DKxai/Upper-Limb-Tracking/Calib/accel_calib2_report.xlsx

Sheet: TongHop
KẾT QUẢ HIỆU CHUẨN ACCEL (mô hình a = S (ã − B))
S (ma trận đối xứng) | col X | col Y | col Z
row X | 1.004494 | 4.3e-05 | 0.003032
row Y | 4.3e-05 | 1.000284 | -0.000519
row Z | 0.003032 | -0.000519 | 0.981801
Bias B | X | Y | Z
g | 0.033737 | -0.008428 | -0.000734
m/s² | 0.330852 | -0.08265 | -0.007194
Chỉ tiêu (||a|| so với g) | TRƯỚC | SAU
RMS sai số (g) | 0.02137 | 0.00018
Max |sai số| (g) | 0.03812 | 0.00045
Std ||a|| (g) | 0.02076 | 0.00018

Sheet: DoiChieu
position | norm_THO_g | norm_HIEUCHUAN_g | chuan_g
1 | 1.01688 | 1.00038 | 1
2 | 1.00165 | 0.99955 | 1
3 | 1.01344 | 0.99985 | 1
4 | 1.02715 | 1.00011 | 1
5 | 0.9845 | 0.9998 | 1
6 | 1.02191 | 1.00014 | 1
7 | 1.01755 | 1.00029 | 1
8 | 1.00792 | 0.99975 | 1
9 | 1.03486 | 1.00007 | 1
10 | 0.98628 | 0.99967 | 1
11 | 0.96188 | 1.00014 | 1
12 | 0.98137 | 0.99999 | 1
13 | 0.96864 | 1.0002 | 1
14 | 0.98628 | 1.00008 | 1
15 | 0.98124 | 1.00004 | 1
16 | 1.0289 | 0.99991 | 1
17 | 1.0271 | 0.9998 | 1
18 | 1.03441 | 0.99981 | 1
19 | 1.01439 | 1.00005 | 1
20 | 1.02616 | 1.00004 | 1
21 | 1.00829 | 0.99984 | 1
22 | 1.01433 | 1.0001 | 1
23 | 1.01633 | 0.99991 | 1
24 | 1.02645 | 1.00005 | 1
25 | 0.98158 | 1.00001 | 1
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
