DKxai/Upper-Limb-Tracking/Calib/accel_calib3_report.xlsx

Sheet: TongHop
KẾT QUẢ HIỆU CHUẨN ACCEL (mô hình a = S (ã − B))
S (ma trận đối xứng) | col X | col Y | col Z
row X | 1.000799 | -0.00019 | -0.000277
row Y | -0.00019 | 0.999013 | -0.002093
row Z | -0.000277 | -0.002093 | 0.980925
Bias B | X | Y | Z
g | 0.021174 | -0.001438 | 0.259063
m/s² | 0.207642 | -0.014107 | 2.540536
Chỉ tiêu (||a|| so với g) | TRƯỚC | SAU
RMS sai số (g) | 0.15611 | 0.00025
Max |sai số| (g) | 0.27923 | 0.0007
Std ||a|| (g) | 0.15222 | 0.00025

Sheet: DoiChieu
position | norm_THO_g | norm_HIEUCHUAN_g | chuan_g
1 | 1.27923 | 1.0007 | 1
2 | 1.21735 | 1.00065 | 1
3 | 1.2212 | 1.00001 | 1
4 | 1.22541 | 0.99964 | 1
5 | 1.24324 | 0.99988 | 1
6 | 0.76073 | 0.99983 | 1
7 | 0.86547 | 1.00002 | 1
8 | 0.83999 | 0.99997 | 1
9 | 0.82242 | 0.99986 | 1
10 | 0.86183 | 1.00012 | 1
11 | 1.00682 | 1.00014 | 1
12 | 1.01954 | 1.00004 | 1
13 | 1.01612 | 1 | 1
14 | 1.18371 | 0.99999 | 1
15 | 0.82091 | 1.00031 | 1
16 | 1.04655 | 1.00003 | 1
17 | 0.847 | 0.99993 | 1
18 | 1.23595 | 0.99964 | 1
19 | 1.04306 | 1.00025 | 1
20 | 1.04699 | 0.99992 | 1
21 | 1.03933 | 1.00002 | 1
22 | 1.21676 | 0.99938 | 1
23 | 0.86581 | 1.00004 | 1
24 | 1.01822 | 0.99978 | 1
25 | 1.05558 | 1.00012 | 1
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
