DKxai/Upper-Limb-Tracking/Calib/accel_calib4_report.xlsx

Sheet: TongHop
KẾT QUẢ HIỆU CHUẨN ACCEL (mô hình a = S (ã − B))
S (ma trận đối xứng) | col X | col Y | col Z
row X | 0.997803 | -7.7e-05 | 0.001582
row Y | -7.7e-05 | 0.994631 | -0.002504
row Z | 0.001582 | -0.002504 | 0.979767
Bias B | X | Y | Z
g | 0.03441 | -0.013384 | -0.06569
m/s² | 0.337451 | -0.131252 | -0.644201
Chỉ tiêu (||a|| so với g) | TRƯỚC | SAU
RMS sai số (g) | 0.04457 | 0.00023
Max |sai số| (g) | 0.09023 | 0.0006
Std ||a|| (g) | 0.04361 | 0.00023

Sheet: DoiChieu
position | norm_THO_g | norm_HIEUCHUAN_g | chuan_g
1 | 0.95234 | 0.99977 | 1
2 | 0.9568 | 0.99954 | 1
3 | 0.97329 | 0.99978 | 1
4 | 0.94228 | 0.99967 | 1
5 | 0.97773 | 0.99994 | 1
6 | 1.09023 | 1.00033 | 1
7 | 1.03603 | 1.0001 | 1
8 | 1.07758 | 1.00011 | 1
9 | 1.05559 | 1.00001 | 1
10 | 1.07964 | 0.99988 | 1
11 | 0.97824 | 1.00006 | 1
12 | 0.97837 | 1.00019 | 1
13 | 0.99422 | 1.00014 | 1
14 | 0.94339 | 1.00033 | 1
15 | 1.04457 | 0.99992 | 1
16 | 1.02931 | 0.99993 | 1
17 | 0.9816 | 0.99994 | 1
18 | 1.07524 | 0.99997 | 1
19 | 1.01787 | 1.00001 | 1
20 | 1.03313 | 1.00005 | 1
21 | 1.02142 | 0.99997 | 1
22 | 0.97375 | 1.00047 | 1
23 | 1.07574 | 0.99975 | 1
24 | 1.03387 | 1.00007 | 1
25 | 0.99757 | 0.99977 | 1
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
