DKxai/Upper-Limb-Tracking/Calib/accel_calib5_report.xlsx

Sheet: TongHop
KẾT QUẢ HIỆU CHUẨN ACCEL (mô hình a = S (ã − B))
S (ma trận đối xứng) | col X | col Y | col Z
row X | 0.99854 | -1.4e-05 | 2.4e-05
row Y | -1.4e-05 | 0.998468 | -0.000963
row Z | 2.4e-05 | -0.000963 | 0.990635
Bias B | X | Y | Z
g | 0.034745 | -0.01351 | -0.006169
m/s² | 0.340734 | -0.13249 | -0.060494
Chỉ tiêu (||a|| so với g) | TRƯỚC | SAU
RMS sai số (g) | 0.02171 | 0.0002
Max |sai số| (g) | 0.03648 | 0.00039
Std ||a|| (g) | 0.02116 | 0.0002

Sheet: DoiChieu
position | norm_THO_g | norm_HIEUCHUAN_g | chuan_g
1 | 1.00782 | 1.00004 | 1
2 | 0.99509 | 1.00013 | 1
3 | 1.01394 | 1.00009 | 1
4 | 0.98549 | 0.99979 | 1
5 | 1.02572 | 1.00031 | 1
6 | 1.01238 | 0.99986 | 1
7 | 0.98501 | 1.00024 | 1
8 | 1.02741 | 1.00032 | 1
9 | 0.99463 | 0.99988 | 1
10 | 1.0187 | 0.99967 | 1
11 | 0.96614 | 0.99971 | 1
12 | 0.98433 | 0.99972 | 1
13 | 0.981 | 1.00018 | 1
14 | 0.9681 | 1.00007 | 1
15 | 0.98943 | 1.00009 | 1
16 | 1.03589 | 0.99978 | 1
17 | 1.01627 | 1.00014 | 1
18 | 1.03531 | 0.99994 | 1
19 | 1.02756 | 0.99999 | 1
20 | 1.03316 | 0.99998 | 1
21 | 1.01727 | 1 | 1
22 | 1.01954 | 1.00032 | 1
23 | 1.0138 | 0.9998 | 1
24 | 0.99 | 1.00017 | 1
25 | 1.03648 | 0.99999 | 1
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
