DKxai/Upper-Limb-Tracking/Calib/accel_calib6_report.xlsx

Sheet: TongHop
KẾT QUẢ HIỆU CHUẨN ACCEL (mô hình a = S (ã − B))
S (ma trận đối xứng) | col X | col Y | col Z
row X | 1.006291 | -7.9e-05 | -0.001651
row Y | -7.9e-05 | 1.003179 | -2.4e-05
row Z | -0.001651 | -2.4e-05 | 0.994116
Bias B | X | Y | Z
g | 0.019748 | -0.010122 | -0.023445
m/s² | 0.193657 | -0.099262 | -0.229912
Chỉ tiêu (||a|| so với g) | TRƯỚC | SAU
RMS sai số (g) | 0.01891 | 0.00033
Max |sai số| (g) | 0.03241 | 0.00093
Std ||a|| (g) | 0.01889 | 0.00033

Sheet: DoiChieu
position | norm_THO_g | norm_HIEUCHUAN_g | chuan_g
1 | 0.98348 | 0.99988 | 1
2 | 0.97737 | 0.99971 | 1
3 | 0.99336 | 0.99959 | 1
4 | 0.96759 | 0.99955 | 1
5 | 0.99791 | 0.99941 | 1
6 | 1.02858 | 1.00093 | 1
7 | 1.0084 | 0.99988 | 1
8 | 1.02781 | 0.99982 | 1
9 | 1.00754 | 1.00001 | 1
10 | 1.02846 | 1.00008 | 1
11 | 0.97473 | 1 | 1
12 | 0.97363 | 1.00009 | 1
13 | 0.98809 | 1.00004 | 1
14 | 1.00536 | 0.99961 | 1
15 | 0.96797 | 1.00025 | 1
16 | 1.01317 | 1.00005 | 1
17 | 0.99932 | 1.00054 | 1
18 | 1.0276 | 0.99982 | 1
19 | 1 | 1 | 1
20 | 1.01828 | 1.00022 | 1
21 | 1.00901 | 1.00019 | 1
22 | 0.98986 | 1.00022 | 1
23 | 1.01595 | 0.99983 | 1
24 | 0.99374 | 1.00043 | 1
25 | 1.02684 | 0.99958 | 1
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
