DKxai/Upper-Limb-Tracking/Calib/accel_calib_report1.xlsx

Sheet: TongHop
KẾT QUẢ HIỆU CHUẨN ACCEL (mô hình a = S (ã − B))
S (ma trận đối xứng) | col X | col Y | col Z
row X | 0.992636 | -0.000123 | 0.001343
row Y | -0.000123 | 0.994363 | -0.00107
row Z | 0.001343 | -0.00107 | 0.989107
Bias B | X | Y | Z
g | 0.044053 | -0.004345 | -0.111994
m/s² | 0.432008 | -0.042612 | -1.098284
Chỉ tiêu (||a|| so với g) | TRƯỚC | SAU
RMS sai số (g) | 0.07178 | 0.00019
Max |sai số| (g) | 0.12463 | 0.00038
Std ||a|| (g) | 0.07041 | 0.00019

Sheet: DoiChieu
position | norm_THO_g | norm_HIEUCHUAN_g | chuan_g
1 | 0.89918 | 0.99966 | 1
2 | 0.95685 | 1.00011 | 1
3 | 0.90087 | 1.00038 | 1
4 | 1.12463 | 0.99996 | 1
5 | 1.12351 | 1.00038 | 1
6 | 1.06949 | 1.00005 | 1
7 | 0.93147 | 0.99997 | 1
8 | 0.93099 | 1.00012 | 1
9 | 1.09451 | 0.99989 | 1
10 | 1.09325 | 0.99988 | 1
11 | 1.00504 | 1.00013 | 1
12 | 1.04196 | 0.99986 | 1
13 | 0.99284 | 0.99996 | 1
14 | 0.92839 | 1.00001 | 1
15 | 1.08845 | 0.99966 | 1
16 | 1.02071 | 1.00006 | 1
17 | 1.04728 | 1.00002 | 1
18 | 0.98945 | 0.99994 | 1
19 | 1.09792 | 0.99993 | 1
20 | 0.93772 | 1.00017 | 1
21 | 1.05681 | 0.99967 | 1
22 | 1.04572 | 0.99985 | 1
23 | 1.04243 | 1.00022 | 1
24 | 0.96418 | 1.00011 | 1
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
