DKxai/Upper-Limb-Tracking/Calib/accel_report.xlsx

Sheet: TongHop
KẾT QUẢ HIỆU CHUẨN ACCEL (mô hình a = S (ã − B))
S (ma trận đối xứng) | col X | col Y | col Z
row X | 1.01028 | -0.072398 | -0.009664
row Y | -0.072398 | 0.987549 | 0.005158
row Z | -0.009664 | 0.005158 | 1.004095
Bias B | X | Y | Z
g | 0.018231 | -0.030919 | 0.015079
m/s² | 0.17878 | -0.303211 | 0.147877
Chỉ tiêu (||a|| so với g) | TRƯỚC | SAU
RMS sai số (g) | 0.02485 | 0.0028
Max |sai số| (g) | 0.04319 | 0.00592
Std ||a|| (g) | 0.02471 | 0.0028

Sheet: DoiChieu
position | norm_THO_g | norm_HIEUCHUAN_g | chuan_g
1 | 1.01065 | 1.00497 | 1
2 | 0.98291 | 1.00585 | 1
3 | 1.01247 | 1.0005 | 1
4 | 0.96738 | 0.99963 | 1
5 | 1.0404 | 1.00037 | 1
6 | 0.98168 | 1.00039 | 1
7 | 1.00628 | 1.00107 | 1
8 | 0.98436 | 0.99911 | 1
9 | 0.99884 | 0.99428 | 1
10 | 1.02461 | 0.99984 | 1
11 | 0.98198 | 0.99408 | 1
12 | 0.98205 | 1.0028 | 1
13 | 0.97137 | 0.99671 | 1
14 | 0.97439 | 0.9965 | 1
15 | 1.04319 | 1.00286 | 1
16 | 1.02406 | 0.99936 | 1
17 | 0.98938 | 1.00239 | 1
18 | 0.98175 | 1.00213 | 1
19 | 0.96515 | 0.99661 | 1
20 | 0.98033 | 0.99948 | 1
21 | 0.96828 | 1.00069 | 1
22 | 0.97952 | 1.00285 | 1
23 | 1.00995 | 1.00118 | 1
24 | 1.03498 | 0.99549 | 1
25 | 1.03921 | 0.99882 | 1
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
