DKxai/Upper-Limb-Tracking/Calib/gyro_calib2_report.xlsx

Sheet: TongHop
KẾT QUẢ HIỆU CHUẨN GYRO (mô hình g = K ⊙ (m + bias))
Trục | Scale K | Bias (°/s)
X | 1.012578 | 3.027168
Y | 0.99328 | 0.485063
Z | 1.02104 | 1.974492
Trục | Góc cuối THÔ (°) | Góc cuối HC (°) | |Sai số| THÔ (°) | |Sai số| HC (°)
X | 386.01 | 360 | 26.01 | 0
Y | 358.57 | 360 | 1.43 | 0
Z | 335.68 | 360 | 24.32 | 0

Sheet: Xoay_X
time_s | Goc_THO_deg | Goc_HIEUCHUAN_deg | Chuan_360
0 | 0.036 | 0 | 360
0.01 | 0.073 | 0.001 | 360
0.02 | 0.11 | 0.001 | 360
0.03 | 0.146 | 0.001 | 360
0.04 | 0.183 | 0.002 | 360
0.05 | 0.219 | 0.002 | 360
0.06 | 0.255 | 0.002 | 360
0.07 | 0.292 | 0.002 | 360
0.08 | 0.329 | 0.002 | 360
0.09 | 0.365 | 0.002 | 360
0.1 | 0.402 | 0.003 | 360
0.11 | 0.438 | 0.003 | 360
0.12 | 0.475 | 0.003 | 360
0.13 | 0.511 | 0.004 | 360
0.14 | 0.547 | 0.004 | 360
0.15 | 0.584 | 0.004 | 360
0.16 | 0.62 | 0.004 | 360
0.17 | 0.657 | 0.003 | 360
0.18 | 0.694 | 0.004 | 360
0.19 | 0.73 | 0.004 | 360
0.2 | 0.766 | 0.004 | 360
0.21 | 0.803 | 0.004 | 360
0.22 | 0.839 | 0.004 | 360
0.23 | 0.876 | 0.005 | 360
0.24 | 0.912 | 0.006 | 360
0.25 | 0.949 | 0.006 | 360
0.26 | 0.986 | 0.007 | 360
0.27 | 1.023 | 0.007 | 360
0.28 | 1.06 | 0.008 | 360
0.29 | 1.097 | 0.008 | 360
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
