DKxai/Upper-Limb-Tracking/Calib/gyro_calib3_report.xlsx

Sheet: TongHop
KẾT QUẢ HIỆU CHUẨN GYRO (mô hình g = K ⊙ (m + bias))
Trục | Scale K | Bias (°/s)
X | 1.018182 | 4.765373
Y | 1.004364 | 0.134336
Z | 1.014789 | 1.157268
Trục | Góc cuối THÔ (°) | Góc cuối HC (°) | |Sai số| THÔ (°) | |Sai số| HC (°)
X | 391.54 | 360 | 31.54 | 0
Y | 360.01 | 360 | 0.01 | 0
Z | 349.08 | 360 | 10.92 | 0

Sheet: Xoay_X
time_s | Goc_THO_deg | Goc_HIEUCHUAN_deg | Chuan_360
0 | 0.049 | 0.001 | 360
0.01 | 0.098 | 0.001 | 360
0.02 | 0.148 | 0.001 | 360
0.03 | 0.197 | 0.001 | 360
0.04 | 0.247 | 0.002 | 360
0.05 | 0.295 | 0.001 | 360
0.06 | 0.344 | 0.002 | 360
0.07 | 0.392 | 0.002 | 360
0.08 | 0.44 | 0.002 | 360
0.09 | 0.488 | 0.003 | 360
0.1 | 0.537 | 0.004 | 360
0.11 | 0.585 | 0.004 | 360
0.12 | 0.633 | 0.005 | 360
0.13 | 0.682 | 0.005 | 360
0.14 | 0.732 | 0.005 | 360
0.15 | 0.781 | 0.005 | 360
0.16 | 0.83 | 0.005 | 360
0.17 | 0.879 | 0.005 | 360
0.18 | 0.928 | 0.005 | 360
0.19 | 0.978 | 0.004 | 360
0.2 | 1.027 | 0.004 | 360
0.21 | 1.076 | 0.005 | 360
0.22 | 1.125 | 0.006 | 360
0.23 | 1.174 | 0.006 | 360
0.24 | 1.224 | 0.006 | 360
0.25 | 1.273 | 0.006 | 360
0.26 | 1.322 | 0.006 | 360
0.27 | 1.371 | 0.007 | 360
0.28 | 1.42 | 0.007 | 360
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
