DKxai/Upper-Limb-Tracking/Calib/gyro_calib4_report.xlsx

Sheet: TongHop
KẾT QUẢ HIỆU CHUẨN GYRO (mô hình g = K ⊙ (m + bias))
Trục | Scale K | Bias (°/s)
X | 1.064836 | 1.540782
Y | 1.000265 | 1.602048
Z | 1.002661 | 0.682987
Trục | Góc cuối THÔ (°) | Góc cuối HC (°) | |Sai số| THÔ (°) | |Sai số| HC (°)
X | 352.58 | 360 | 7.42 | 0
Y | 348.33 | 360 | 11.67 | 0
Z | 356.16 | 360 | 3.84 | 0

Sheet: Xoay_X
time_s | Goc_THO_deg | Goc_HIEUCHUAN_deg | Chuan_360
0 | 0.023 | 0.001 | 360
0.01 | 0.046 | 0.001 | 360
0.02 | 0.069 | 0.001 | 360
0.03 | 0.092 | 0.001 | 360
0.04 | 0.115 | 0.002 | 360
0.05 | 0.138 | 0.002 | 360
0.06 | 0.161 | 0.003 | 360
0.07 | 0.184 | 0.003 | 360
0.08 | 0.208 | 0.002 | 360
0.09 | 0.231 | 0.002 | 360
0.1 | 0.255 | 0.002 | 360
0.11 | 0.279 | 0.002 | 360
0.12 | 0.311 | 0.039 | 360
0.13 | 0.368 | 0.136 | 360
0.14 | 0.459 | 0.281 | 360
0.15 | 0.584 | 0.471 | 360
0.16 | 0.752 | 0.714 | 360
0.17 | 0.979 | 1.001 | 360
0.18 | 1.266 | 1.316 | 360
0.19 | 1.583 | 1.634 | 360
0.2 | 1.922 | 1.962 | 360
0.21 | 2.261 | 2.291 | 360
0.22 | 2.521 | 2.541 | 360
0.23 | 2.711 | 2.716 | 360
0.24 | 2.834 | 2.817 | 360
0.25 | 2.88 | 2.825 | 360
0.26 | 2.901 | 2.784 | 360
0.27 | 2.941 | 2.739 | 360
0.28 | 2.986 | 2.691 | 360
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
