DKxai/Upper-Limb-Tracking/Calib/gyro_calib5_report.xlsx

Sheet: TongHop
KẾT QUẢ HIỆU CHUẨN GYRO (mô hình g = K ⊙ (m + bias))
Trục | Scale K | Bias (°/s)
X | 1.024436 | 3.463328
Y | 1.004863 | 0.484768
Z | 1.005387 | -0.360059
Trục | Góc cuối THÔ (°) | Góc cuối HC (°) | |Sai số| THÔ (°) | |Sai số| HC (°)
X | 385.57 | 360 | 25.57 | 0
Y | 357.74 | 360 | 2.26 | 0
Z | 359.12 | 360 | 0.88 | 0

Sheet: Xoay_X
time_s | Goc_THO_deg | Goc_HIEUCHUAN_deg | Chuan_360
0 | 0.035 | 0 | 360
0.01 | 0.07 | 0 | 360
0.02 | 0.105 | 0.001 | 360
0.03 | 0.141 | 0.001 | 360
0.04 | 0.176 | 0.001 | 360
0.05 | 0.21 | 0.001 | 360
0.06 | 0.245 | 0.002 | 360
0.07 | 0.28 | 0.002 | 360
0.08 | 0.314 | 0.003 | 360
0.09 | 0.349 | 0.003 | 360
0.1 | 0.384 | 0.004 | 360
0.11 | 0.418 | 0.004 | 360
0.12 | 0.453 | 0.005 | 360
0.13 | 0.487 | 0.006 | 360
0.14 | 0.521 | 0.007 | 360
0.15 | 0.555 | 0.007 | 360
0.16 | 0.59 | 0.008 | 360
0.17 | 0.626 | 0.007 | 360
0.18 | 0.661 | 0.007 | 360
0.19 | 0.696 | 0.007 | 360
0.2 | 0.731 | 0.007 | 360
0.21 | 0.766 | 0.008 | 360
0.22 | 0.801 | 0.007 | 360
0.23 | 0.837 | 0.007 | 360
0.24 | 0.872 | 0.007 | 360
0.25 | 0.907 | 0.008 | 360
0.26 | 0.942 | 0.008 | 360
0.27 | 0.977 | 0.007 | 360
0.28 | 1.012 | 0.007 | 360
0.29 | 1.047 | 0.007 | 360
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
