DKxai/Upper-Limb-Tracking/Calib/gyro_calib6_report.xlsx

Sheet: TongHop
KẾT QUẢ HIỆU CHUẨN GYRO (mô hình g = K ⊙ (m + bias))
Trục | Scale K | Bias (°/s)
X | 1.016752 | 1.281057
Y | 0.987832 | -2.744873
Z | 1.024926 | 0.020558
Trục | Góc cuối THÔ (°) | Góc cuối HC (°) | |Sai số| THÔ (°) | |Sai số| HC (°)
X | 362.92 | 360 | 2.92 | 0
Y | 379.98 | 360 | 19.98 | 0
Z | 348.92 | 360 | 11.08 | 0

Sheet: Xoay_X
time_s | Goc_THO_deg | Goc_HIEUCHUAN_deg | Chuan_360
0 | 0.03 | 0.001 | 360
0.01 | 0.061 | 0.001 | 360
0.02 | 0.091 | 0.002 | 360
0.03 | 0.121 | 0.002 | 360
0.04 | 0.151 | 0.002 | 360
0.05 | 0.182 | 0.002 | 360
0.06 | 0.212 | 0.002 | 360
0.07 | 0.243 | 0.002 | 360
0.08 | 0.273 | 0.002 | 360
0.09 | 0.304 | 0.002 | 360
0.1 | 0.334 | 0.003 | 360
0.11 | 0.364 | 0.003 | 360
0.12 | 0.395 | 0.003 | 360
0.13 | 0.425 | 0.004 | 360
0.14 | 0.456 | 0.004 | 360
0.15 | 0.486 | 0.004 | 360
0.16 | 0.517 | 0.004 | 360
0.17 | 0.547 | 0.004 | 360
0.18 | 0.577 | 0.004 | 360
0.19 | 0.607 | 0.004 | 360
0.2 | 0.637 | 0.004 | 360
0.21 | 0.667 | 0.005 | 360
0.22 | 0.697 | 0.006 | 360
0.23 | 0.726 | 0.009 | 360
0.24 | 0.756 | 0.033 | 360
0.25 | 0.792 | 0.14 | 360
0.26 | 0.867 | 0.292 | 360
0.27 | 0.974 | 0.465 | 360
0.28 | 1.105 | 0.652 | 360
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
