DKxai/Upper-Limb-Tracking/Calib/gyro_calib_report1.xlsx

Sheet: TongHop
KẾT QUẢ HIỆU CHUẨN GYRO (mô hình g = K ⊙ (m + bias))
Trục | Scale K | Bias (°/s)
X | 1.056742 | 0.803163
Y | 1.001935 | -0.989652
Z | 1.014618 | 1.323389
Trục | Góc cuối THÔ (°) | Góc cuối HC (°) | |Sai số| THÔ (°) | |Sai số| HC (°)
X | 352.59 | 360 | 7.41 | 0
Y | 369.26 | 360 | 9.26 | 0
Z | 338.13 | 360 | 21.87 | 0

Sheet: Xoay_X
time_s | Goc_THO_deg | Goc_HIEUCHUAN_deg | Chuan_360
0 | 0.018 | 0.001 | 360
0.01 | 0.037 | 0.001 | 360
0.02 | 0.056 | 0.001 | 360
0.03 | 0.074 | 0.001 | 360
0.04 | 0.093 | 0.002 | 360
0.05 | 0.112 | 0.002 | 360
0.06 | 0.131 | 0.002 | 360
0.07 | 0.149 | 0.002 | 360
0.08 | 0.167 | 0.002 | 360
0.09 | 0.185 | 0.002 | 360
0.1 | 0.203 | 0.002 | 360
0.11 | 0.221 | 0.002 | 360
0.12 | 0.239 | 0.002 | 360
0.13 | 0.257 | 0.002 | 360
0.14 | 0.275 | 0.002 | 360
0.15 | 0.293 | 0.002 | 360
0.16 | 0.312 | 0.002 | 360
0.17 | 0.331 | 0.001 | 360
0.18 | 0.349 | 0.001 | 360
0.19 | 0.367 | 0.001 | 360
0.2 | 0.386 | 0 | 360
0.21 | 0.404 | 0 | 360
0.22 | 0.422 | 0 | 360
0.23 | 0.44 | 0.001 | 360
0.24 | 0.459 | 0.001 | 360
0.25 | 0.477 | 0.001 | 360
0.26 | 0.496 | 0.001 | 360
0.27 | 0.515 | 0.002 | 360
0.28 | 0.533 | 0.002 | 360
0.29 | 0.551 | 0.003 | 360
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
