DKxai/Upper-Limb-Tracking/calibration/gyro_report.xlsx

Sheet: TongHop
KẾT QUẢ HIỆU CHUẨN GYRO (mô hình g = K ⊙ (m + bias))
Trục | Scale K | Bias (°/s)
X | 1.050159 | 0.804507
Y | 0.970112 | -0.602689
Z | 1.020031 | 1.096927
Trục | Góc cuối THÔ (°) | Góc cuối HC (°) | |Sai số| THÔ (°) | |Sai số| HC (°)
X | 339.63 | 360 | 20.37 | 0
Y | 373.54 | 360 | 13.54 | 0
Z | 348.57 | 360 | 11.43 | 0

Sheet: Xoay_X
time_s | Goc_THO_deg | Goc_HIEUCHUAN_deg | Chuan_360
0 | 0.016 | 0.002 | 360
0.01 | 0.029 | 0.008 | 360
0.02 | 0.041 | 0.03 | 360
0.03 | 0.063 | 0.065 | 360
0.04 | 0.094 | 0.108 | 360
0.05 | 0.135 | 0.164 | 360
0.06 | 0.188 | 0.229 | 360
0.07 | 0.25 | 0.304 | 360
0.08 | 0.325 | 0.393 | 360
0.09 | 0.411 | 0.493 | 360
0.1 | 0.507 | 0.604 | 360
0.11 | 0.619 | 0.73 | 360
0.12 | 0.736 | 0.862 | 360
0.13 | 0.866 | 1.007 | 360
0.14 | 1.006 | 1.163 | 360
0.15 | 1.155 | 1.328 | 360
0.16 | 1.311 | 1.501 | 360
0.17 | 1.481 | 1.688 | 360
0.18 | 1.662 | 1.886 | 360
0.19 | 1.853 | 2.096 | 360
0.2 | 2.052 | 2.313 | 360
0.21 | 2.264 | 2.545 | 360
0.22 | 2.488 | 2.789 | 360
0.23 | 2.721 | 3.041 | 360
0.24 | 2.962 | 3.303 | 360
0.25 | 3.216 | 3.579 | 360
0.26 | 3.482 | 3.867 | 360
0.27 | 3.755 | 4.162 | 360
0.28 | 4.041 | 4.471 | 360
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
