DKxai/Upper-Limb-Tracking/Calib/PlotIMU/bland_altman.png

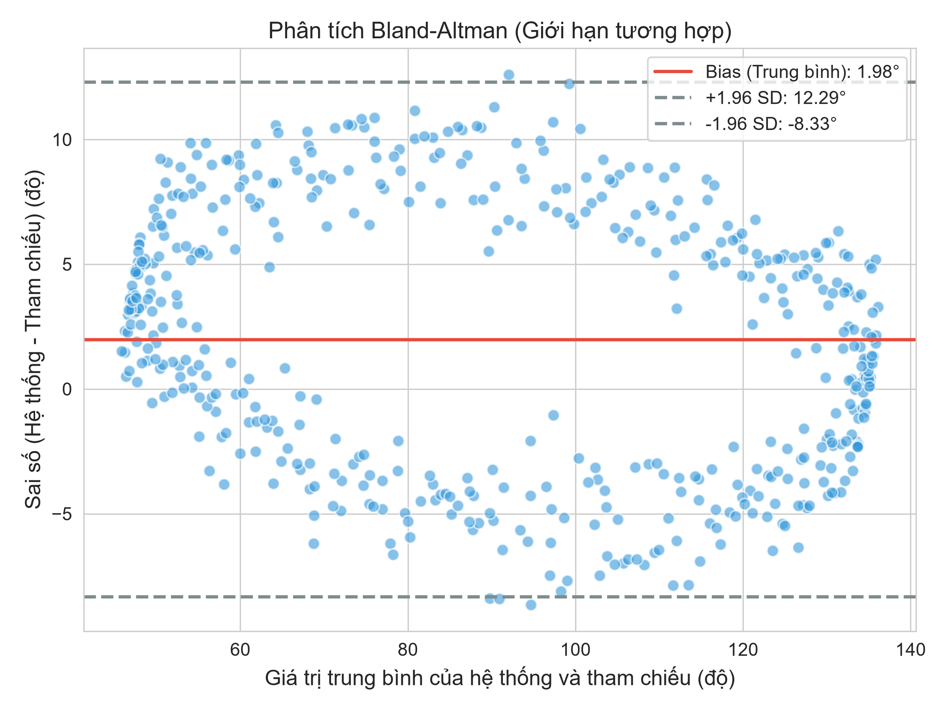
Calib/PlotIMU/bland_altman.png
