DKxai/Upper-Limb-Tracking/Calib/PlotIMU/calib_before_after.png

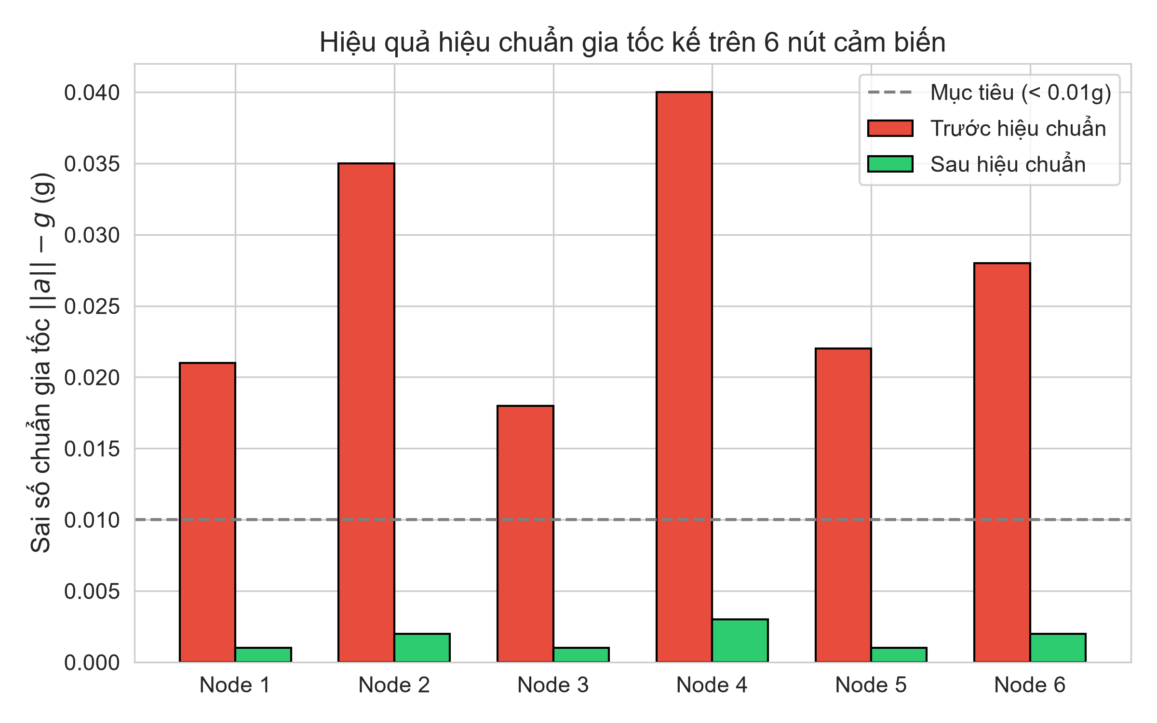
Calib/PlotIMU/calib_before_after.png
