DKxai/Upper-Limb-Tracking/Calib/PlotIMU/timeseries_error.png

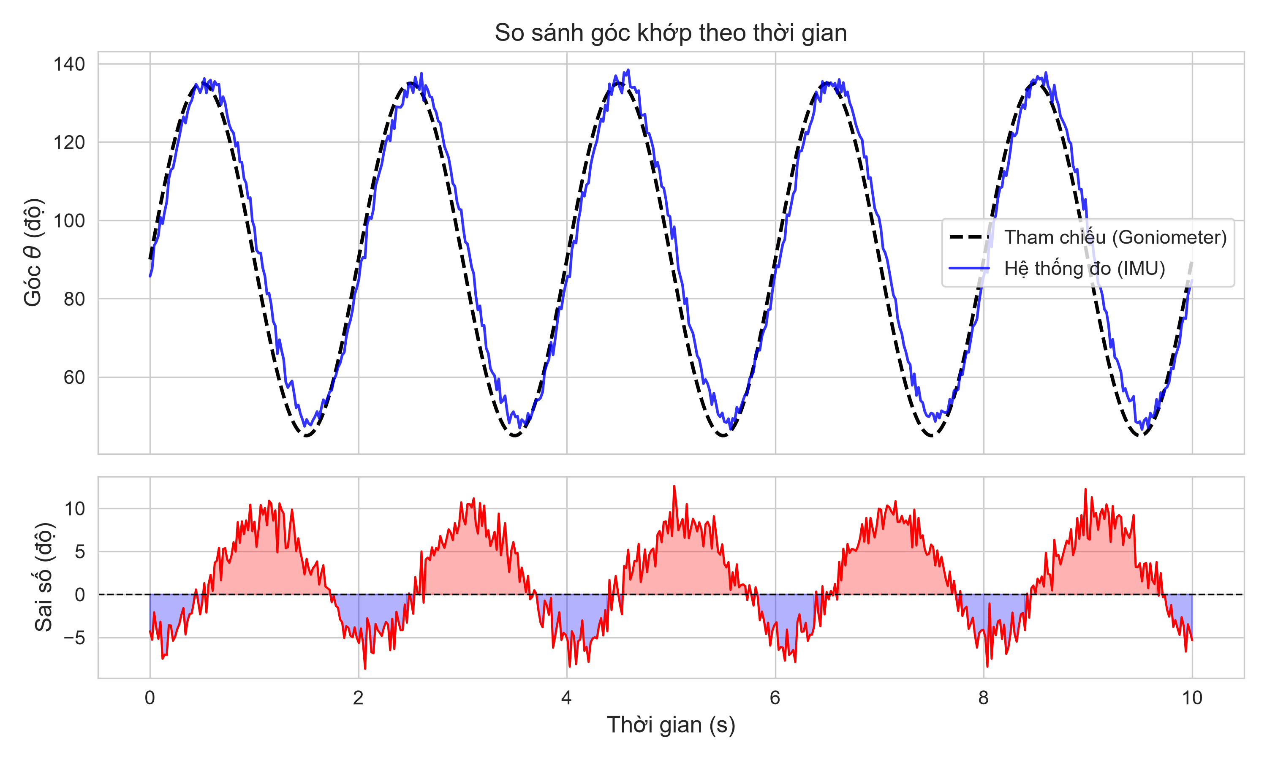
Calib/PlotIMU/timeseries_error.png
