DKxai/Upper-Limb-Tracking/Calib/static_accuracy.png

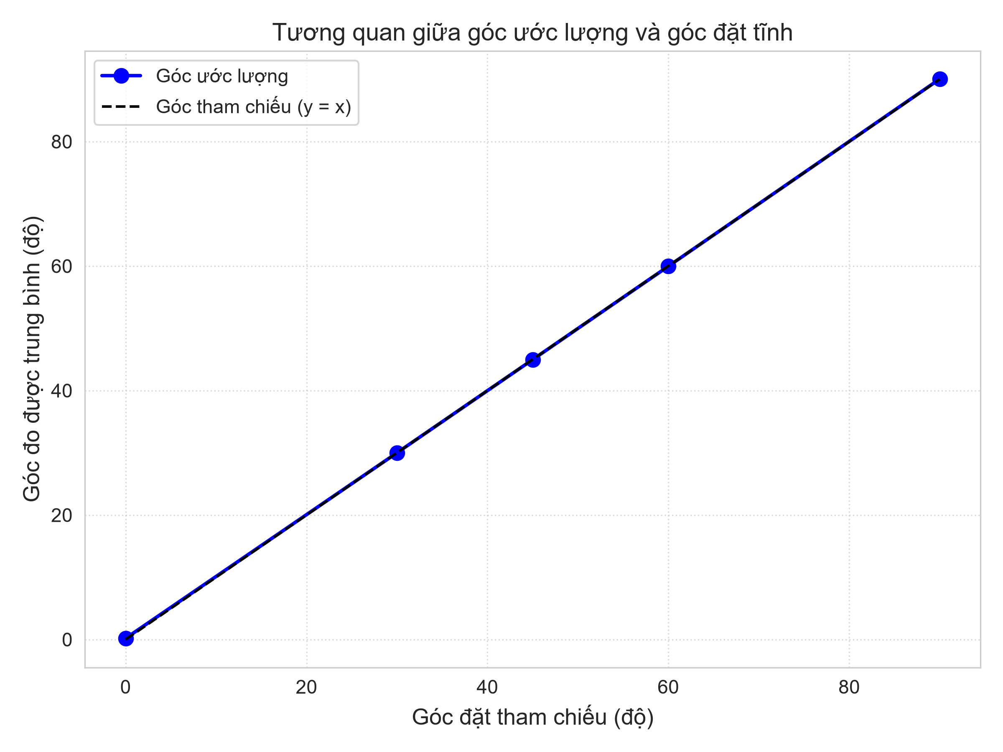
Calib/static_accuracy.png
