DKxai/Upper-Limb-Tracking/Calib/static_accuracy_chart.png

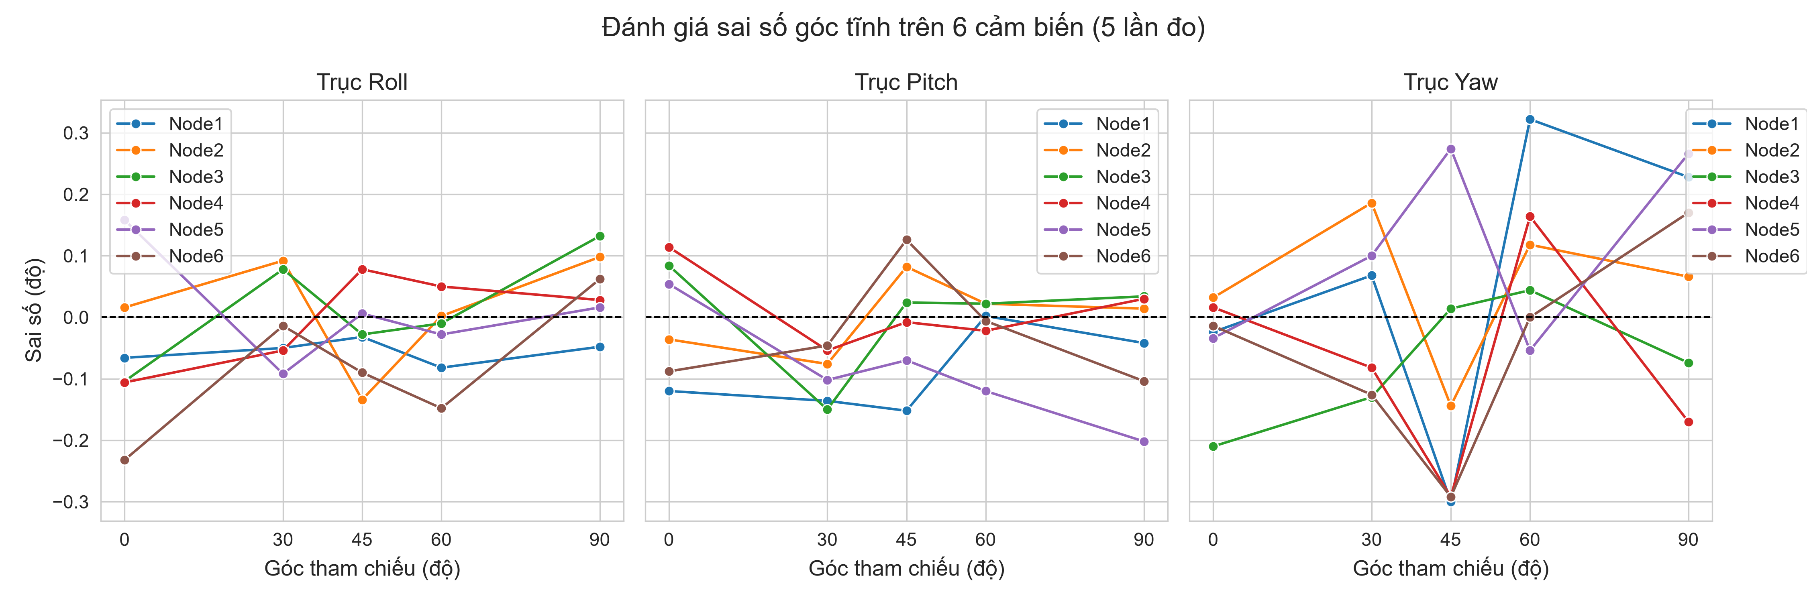
Calib/static_accuracy_chart.png
