DKxai/Upper-Limb-Tracking/calibration/accel_template.xlsx

Sheet: Data
position | ax_g | ay_g | az_g
1 | 1.00969 | -0.03673 | 0.02425
2 | 0.00477 | 0.98284 | 0.01068
3 | 0.02578 | -0.03378 | 1.01158
4 | -0.96713 | -0.01987 | 0.00926
5 | 0.02707 | -1.03987 | 0.01918
6 | 0.01447 | -0.02374 | -0.98129
7 | 1.00518 | -0.04105 | 0.02296
8 | 0.71213 | -0.02759 | -0.67903
9 | 0.99746 | -0.04758 | 0.02223
10 | 0.72275 | -0.04055 | 0.72513
11 | 0.02699 | 0.67486 | 0.71283
12 | 0.01815 | 0.98181 | 0.01155
13 | 0.00525 | 0.68135 | -0.69231
14 | 0.01042 | 0.97431 | 0.00616
15 | 0.0324 | -0.75172 | 0.72258
16 | 0.72482 | -0.04126 | 0.72224
17 | 0.02089 | 0.68287 | 0.71563
18 | -0.6765 | -0.0243 | 0.71105
19 | -0.96479 | -0.02427 | 0.01073
20 | -0.67331 | -0.03223 | 0.7118
21 | -0.96809 | -0.01889 | 0.00314
22 | -0.68887 | -0.0178 | -0.69613
23 | 0.02242 | -0.73627 | -0.69094
24 | 0.03104 | -1.03432 | 0.01991
25 | 0.02945 | -0.74493 | 0.72399
26 | 0.0336 | -1.0406 | 0.01518
27 | 0.00687 | 0.68616 | -0.68987
28 | -0.68367 | -0.02512 | -0.69905
29 | 0.02502 | -0.73659 | -0.6869
30 | 0.71323 | -0.03099 | -0.68118
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
