DKxai/Upper-Limb-Tracking/calibration/gyro_template.xlsx

Sheet: Data
time_s | stage | gx_dps | gy_dps | gz_dps
0 | 0 | -0.7811 | 0.5802 | -1.0039
0.01 | 0 | -0.7843 | 0.5196 | -1.0458
0.02 | 0 | -0.6044 | 0.7421 | -1.2056
0.03 | 0 | -0.9898 | 0.5065 | -1.0938
0.04 | 0 | -1.1488 | 0.5672 | -1.2869
0.05 | 0 | -0.9098 | 0.5184 | -1.1474
0.06 | 0 | -0.7383 | 0.7564 | -1.1193
0.07 | 0 | -0.595 | 0.5002 | -1.0473
0.08 | 0 | -0.6645 | 0.6141 | -1.2115
0.09 | 0 | -0.9383 | 0.5313 | -1.067
0.1 | 0 | -0.9514 | 0.5686 | -1.1239
0.11 | 0 | -0.7189 | 0.6322 | -1.0467
0.12 | 0 | -0.8981 | 0.5806 | -0.9824
0.13 | 0 | -0.576 | 0.4111 | -0.8729
0.14 | 0 | -0.5981 | 0.7172 | -1.0603
0.15 | 0 | -0.8471 | 0.8187 | -0.806
0.16 | 0 | -0.5298 | 0.7973 | -1.0464
0.17 | 0 | -0.9812 | 0.5993 | -1.0015
0.18 | 0 | -0.9933 | 0.6593 | -1.0355
0.19 | 0 | -0.6956 | 0.4224 | -1.1993
0.2 | 0 | -0.8655 | 0.4245 | -0.8391
0.21 | 0 | -0.8744 | 0.6493 | -1.1388
0.22 | 0 | -0.5625 | 0.7981 | -1.005
0.23 | 0 | -1.1305 | 0.6078 | -0.9974
0.24 | 0 | -0.6494 | 0.5073 | -0.8267
0.25 | 0 | -0.9981 | 0.5008 | -0.9597
0.26 | 0 | -0.7926 | 0.9004 | -1.0717
0.27 | 0 | -0.895 | 0.5434 | -1.2637
0.28 | 0 | -0.9917 | 0.6946 | -1.0128
0.29 | 0 | -0.6058 | 0.4868 | -0.8466
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
