DKxai/Upper-Limb-Tracking/Calib/calib_accel_result.png

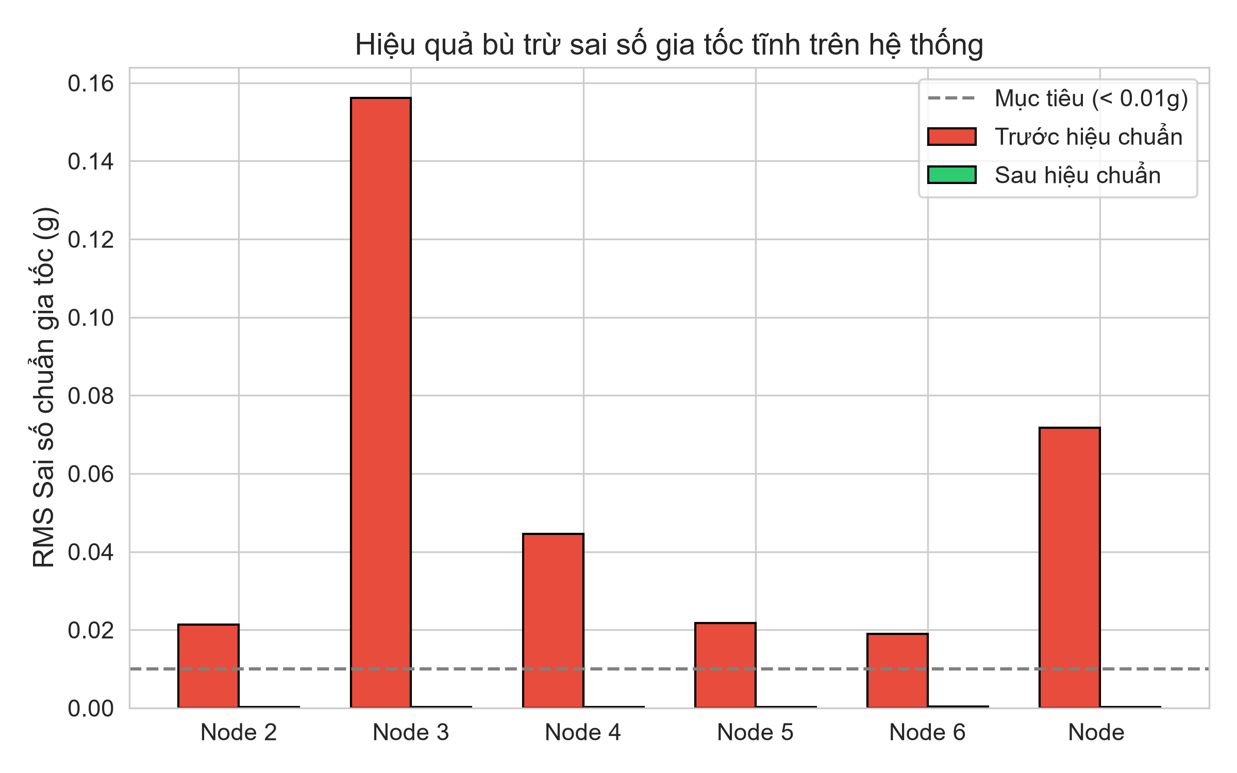
Calib/calib_accel_result.png
