DKxai/Upper-Limb-Tracking/(commit log)

2026-07-11 Update the visual
    [accel_report.xlsx, accel_template.xlsx, gyro_report.xlsx, gyro_template.xlsx]
2026-07-15 Final Version
    [accel_calib1.xlsx, accel_calib2.xlsx, accel_calib2_report.xlsx, accel_calib3.xlsx, accel_calib3_report.xlsx, accel_calib4.xlsx, accel_calib4_report.xlsx, accel_calib5.xlsx]
